yakamasiinen/chromatography-column-rack/stl/column_rack_5mL_3x8_256mm.stl

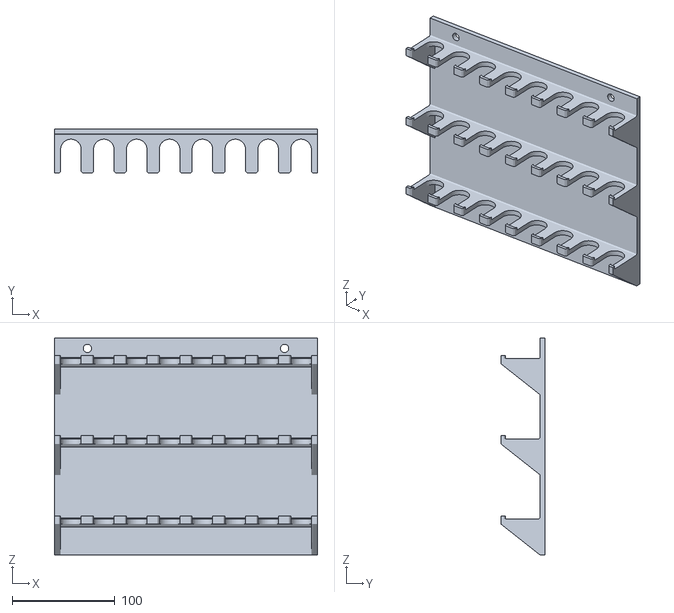
[picture p2: CAD file, 2026-10-14]
stl/column_rack_5mL_3x8_256mm.stl
256.0 x 43.0 x 211.0
