yakamasiinen/chromatography-column-rack/stl/column_rack_1mL_3x12.stl

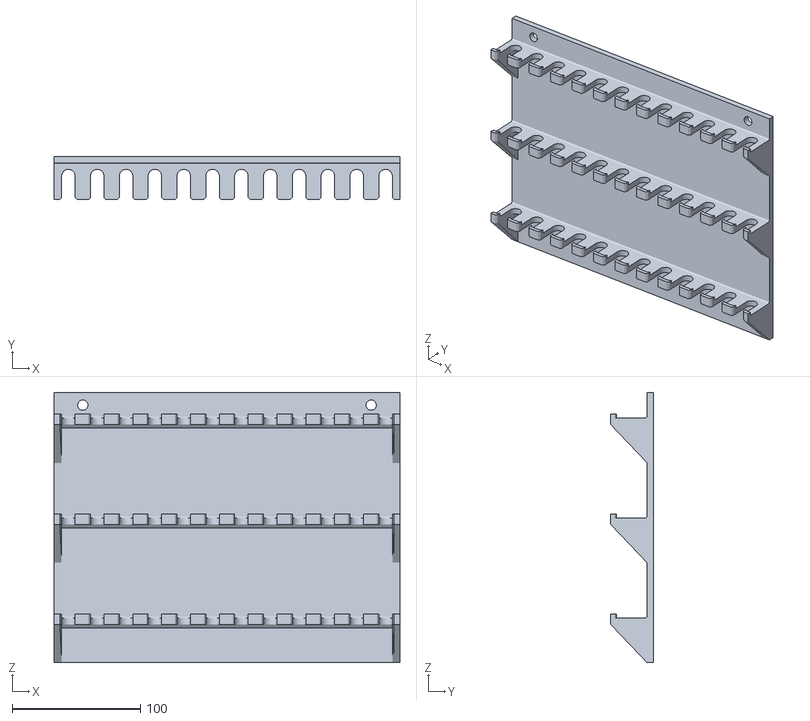
[picture p3: CAD file, 2026-10-14]
stl/column_rack_1mL_3x12.stl
270.0 x 33.5 x 211.0
