yakamasiinen/chromatography-column-rack/stl/column_rack_5mL_3x9_feet.stl

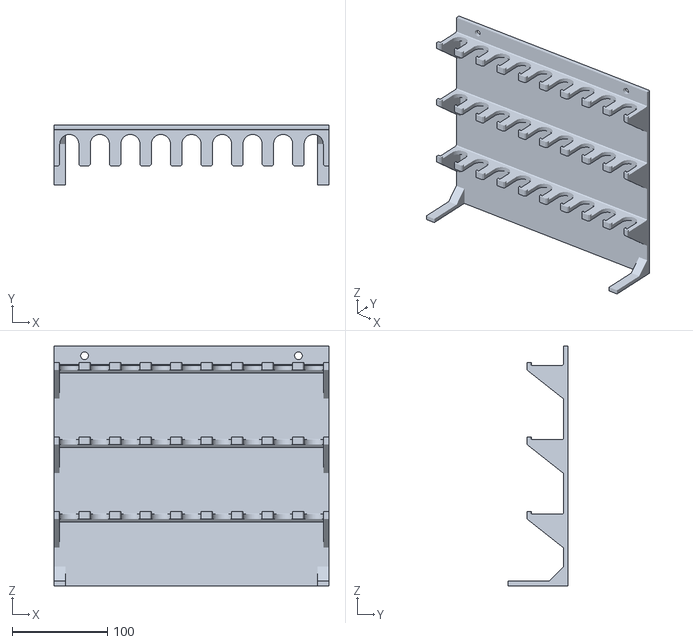
[picture p4: CAD file, 2026-10-14]
stl/column_rack_5mL_3x9_feet.stl
288.0 x 63.0 x 251.0
