yakamasiinen/chromatography-column-rack/stl/column_rack_5mL_3x9.stl

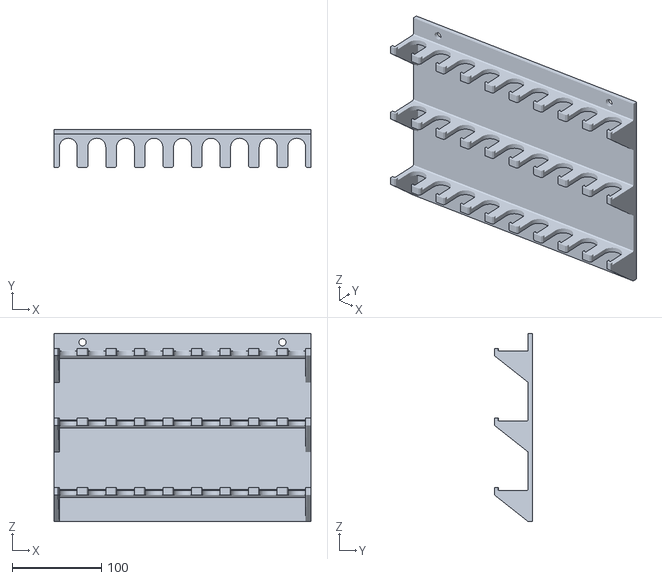
[picture p5: CAD file, 2026-10-14]
stl/column_rack_5mL_3x9.stl
288.0 x 43.0 x 211.0
