yakamasiinen/chromatography-column-rack/stl/column_rack_1x12-5x9-5x9.stl

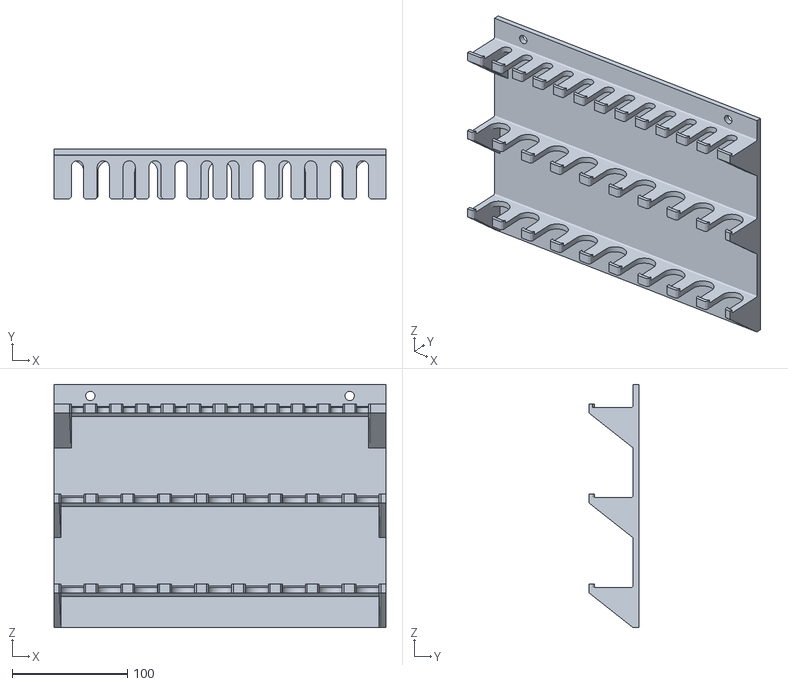
[picture p6: CAD file, 2026-10-14]
stl/column_rack_1x12-5x9-5x9.stl
288.0 x 43.0 x 211.0
